OpenBehavior/ACRoBaT-center-out-task-platform/build-files/stl-autocad-files/Target - Left Slot.stl

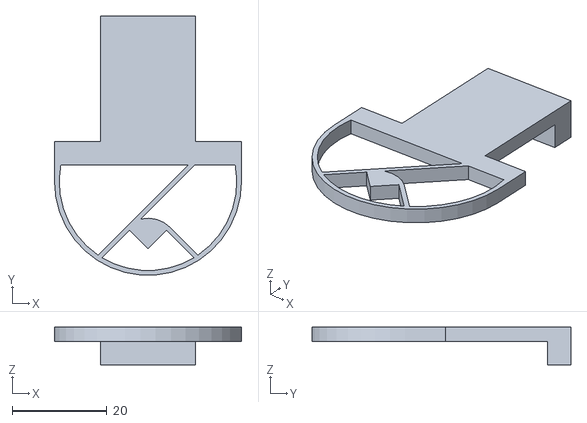
[picture p3: CAD file, 2017-10-06]
build-files/stl-autocad-files/Target - Left Slot.stl
39.5 x 54.7 x 8.00
