OpenBehavior/ACRoBaT-center-out-task-platform/build-files/stl-autocad-files/Joystick - Shaft.stl

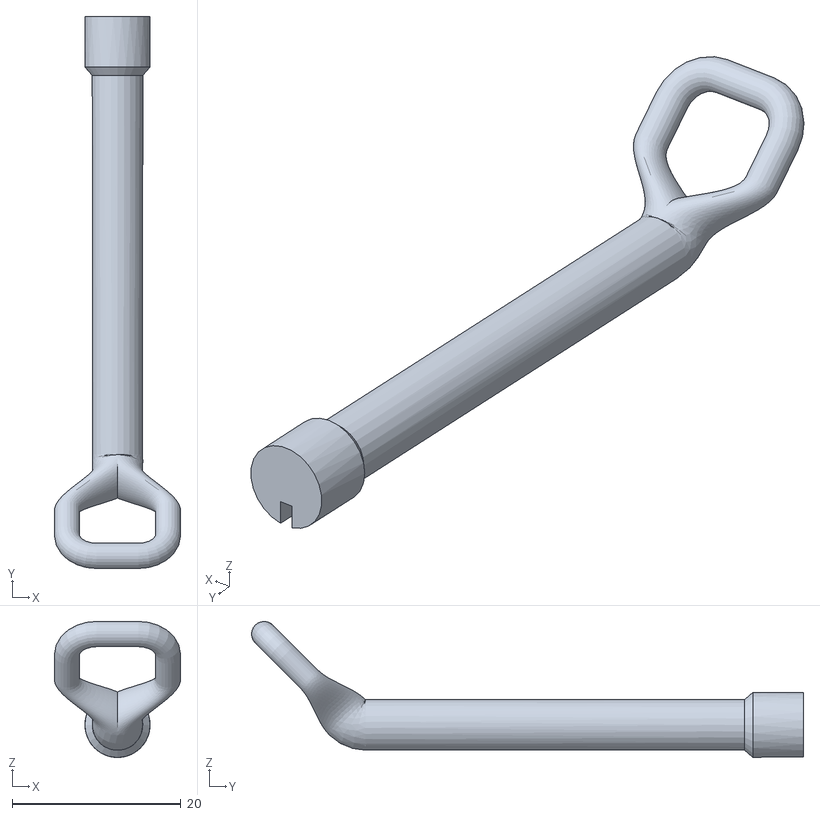
[picture p4: CAD file, 2017-10-06]
build-files/stl-autocad-files/Joystick - Shaft.stl
15.0 x 65.5 x 16.2
