OpenBehavior/ACRoBaT-center-out-task-platform/build-files/stl-autocad-files/Joystick - Female Socket.stl

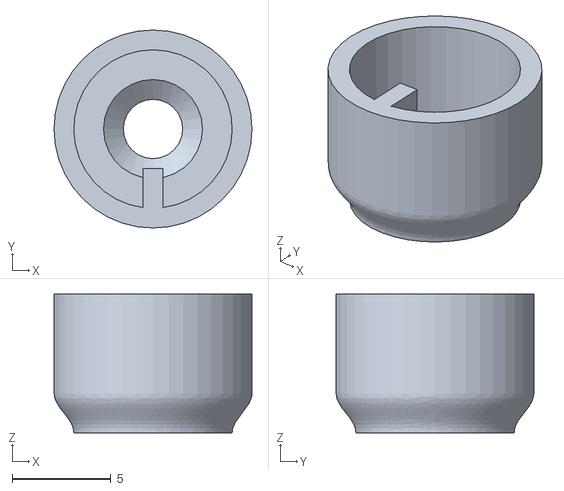
[picture p5: CAD file, 2017-10-06]
build-files/stl-autocad-files/Joystick - Female Socket.stl
10.0 x 10.0 x 7.00
