OpenBehavior/ACRoBaT-center-out-task-platform/build-files/stl-autocad-files/Targets - 3 Slots.stl

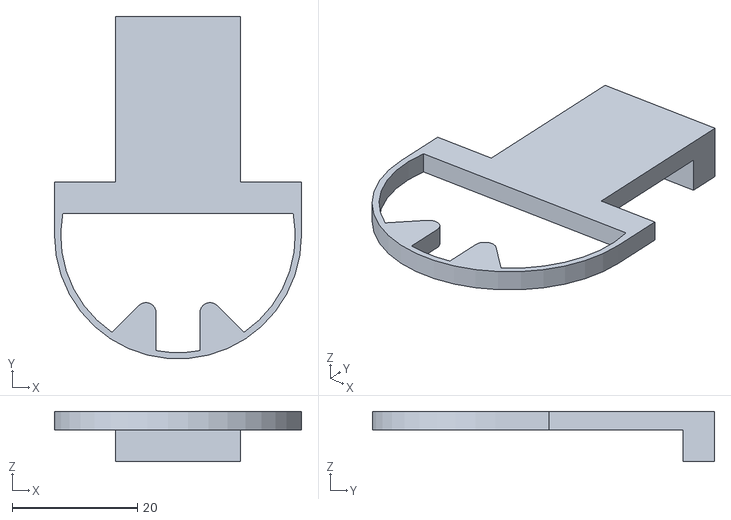
[picture p6: CAD file, 2017-10-06]
build-files/stl-autocad-files/Targets - 3 Slots.stl
39.5 x 54.7 x 8.00
