OpenBehavior/ACRoBaT-center-out-task-platform/build-files/stl-autocad-files/Arena Mounting Plate - Right.stl

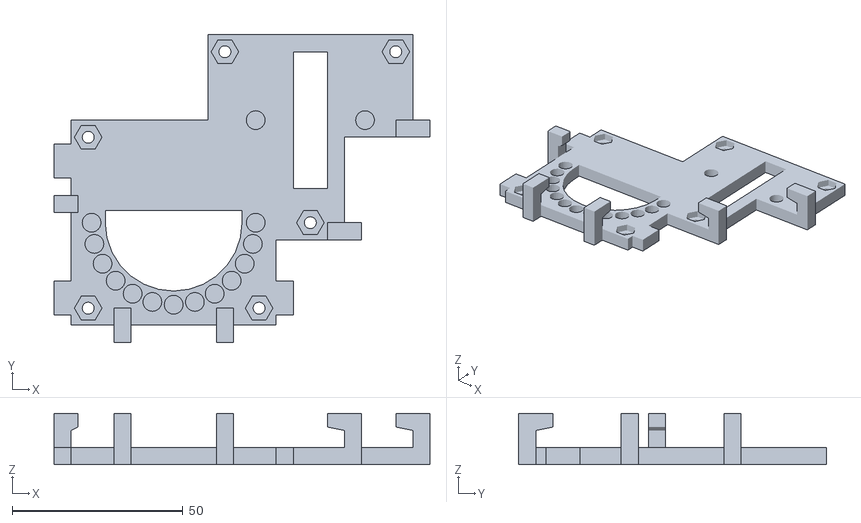
[picture p7: CAD file, 2017-10-06]
build-files/stl-autocad-files/Arena Mounting Plate - Right.stl
110.0 x 90.0 x 15.0
