OpenBehavior/ACRoBaT-center-out-task-platform/build-files/stl-autocad-files/Mounting Bracket - Sipper Tube.stl

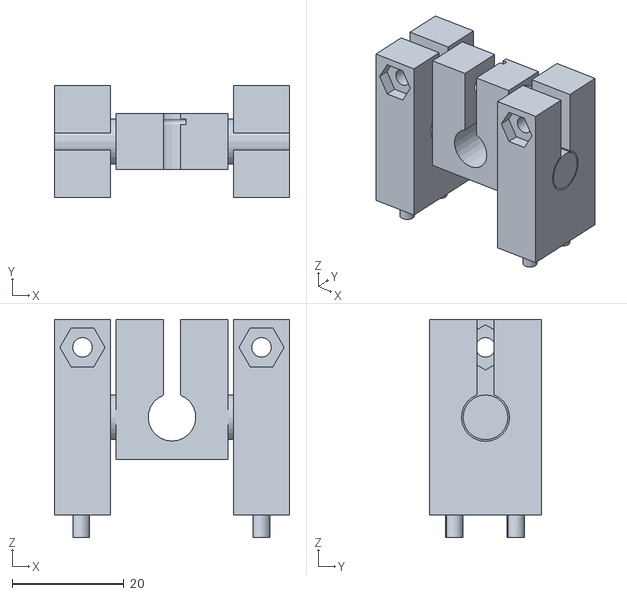
[picture p8: CAD file, 2017-10-06]
build-files/stl-autocad-files/Mounting Bracket - Sipper Tube.stl
42.0 x 20.0 x 39.0
