OpenBehavior/ACRoBaT-center-out-task-platform/build-files/stl-autocad-files/Mounting Bracket - Peristaltic Pump and Juice.stl

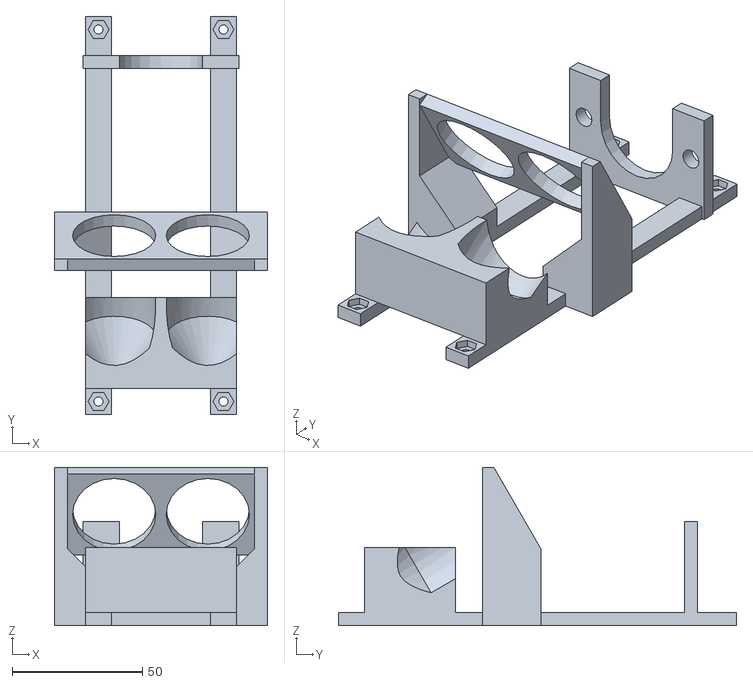
[picture p9: CAD file, 2017-10-06]
build-files/stl-autocad-files/Mounting Bracket - Peristaltic Pump and Juice.stl
82.0 x 153.0 x 60.7
