OpenBehavior/ACRoBaT-center-out-task-platform/build-files/stl-autocad-files/ACRoBaT Base Place - Left.stl

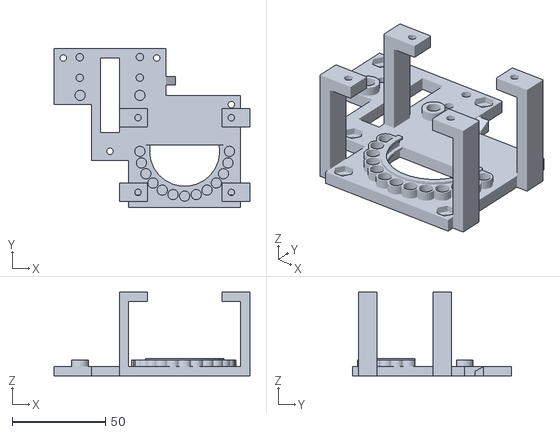
[picture p10: CAD file, 2017-10-06]
build-files/stl-autocad-files/ACRoBaT Base Place - Left.stl
105.0 x 85.0 x 45.0
