OpenBehavior/ACRoBaT-center-out-task-platform/build-files/stl-autocad-files/Mounting Bracket - Hall Effect Joystick.stl

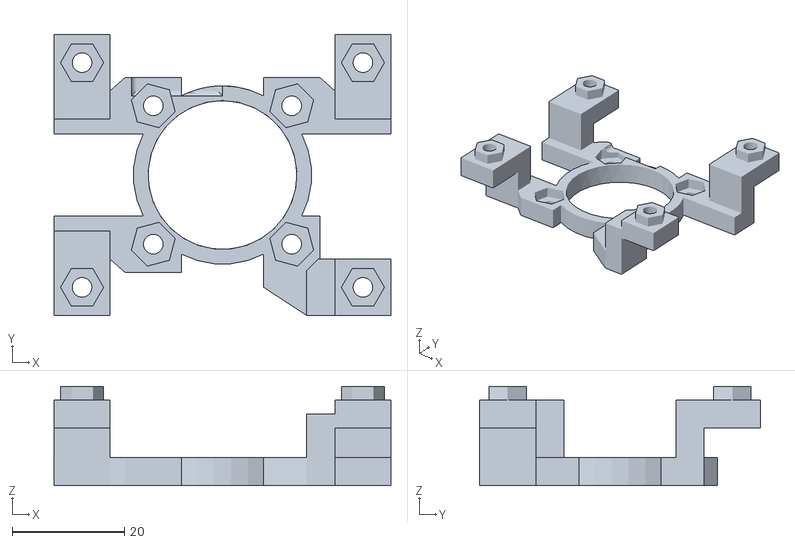
[picture p11: CAD file, 2017-10-06]
build-files/stl-autocad-files/Mounting Bracket - Hall Effect Joystick.stl
60.0 x 50.0 x 17.7
