OpenBehavior/ACRoBaT-center-out-task-platform/build-files/stl-autocad-files/Targets - 2 Slots.stl

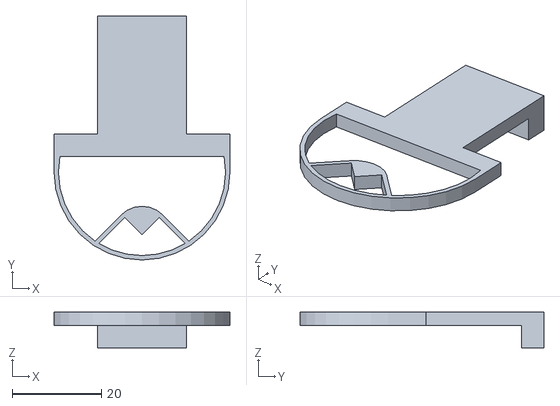
[picture p12: CAD file, 2017-10-06]
build-files/stl-autocad-files/Targets - 2 Slots.stl
39.5 x 54.8 x 8.00
