OpenBehavior/ACRoBaT-center-out-task-platform/(list of files, cad)

Other CAD files:
build-files/stl-autocad-files/Targets - Right Slot.stl
build-files/stl-autocad-files/Arena Mounting Plate - Left.stl
build-files/stl-autocad-files/ACRoBaT Base Plate - Right.stl
