OpenBehavior/ACRoBaT-center-out-task-platform/build-files/pcb-brd-files/ACRoBaT - main board.brd

## EAGLE design build-files/pcb-brd-files/ACRoBaT - main board.brd (2017-10-06)

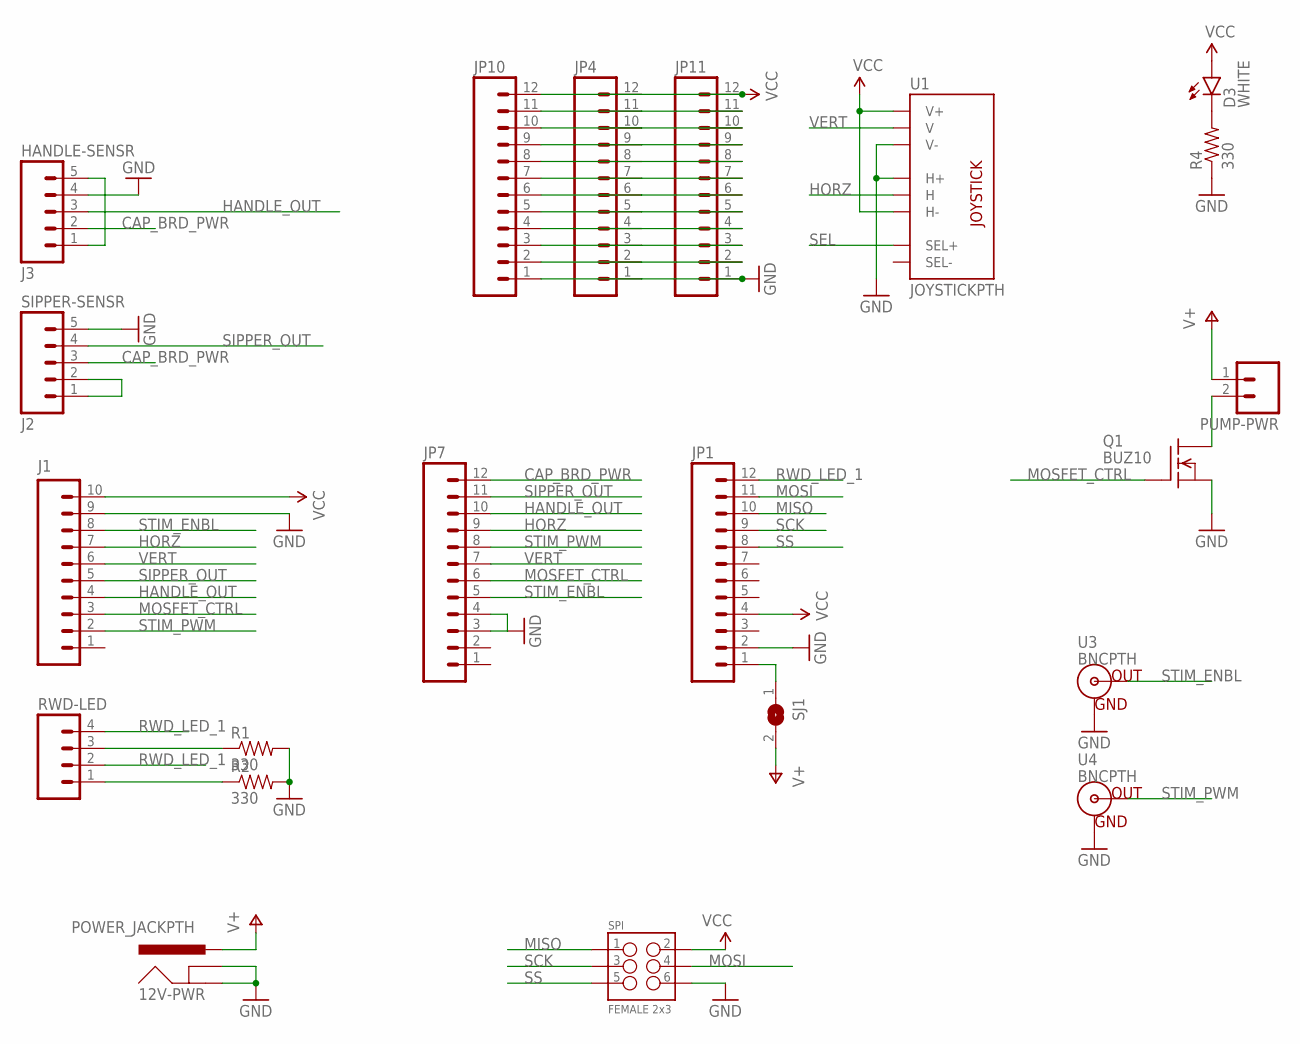
[picture p13: schematic ACRoBaT - main board.sch]

Parts:
12V-PWR: POWER_JACKPTH; POWER_JACK_PTH
D3: WHITE; LED-1206
HANDLE-SENSR: J3; 1X05
J1: M10SILK_FEMALE_PTH; 1X10
JP1, JP4, JP7, JP10, JP11: M12PTH; 1X12
PUMP-PWR: M02PTH; 1X02
Q1: BUZ10; TO220
R1, R2, R4: 330; AXIAL-0.3
RWD-LED: M04PTH; 1X04
SIPPER-SENSR: J2; 1X05
SJ1: SJ
SPI: FEMALE 2x3; 2X3
U1: JOYSTICKPTH; JOYSTICK
U3, U4: BNCPTH; BNC

Connections:
CAP_BRD_PWR: HANDLE-SENSR.2, JP7.12, SIPPER-SENSR.3
GND: 12V-PWR.GND, 12V-PWR.GNDBREAK, HANDLE-SENSR.4, J1.9, JP1.2, JP4.1, JP7.3, JP7.4, JP10.1, JP11.1, Q1.3 (S), R1.P$2 (2), R2.P$2 (2), R4.P$1 (1), SIPPER-SENSR.5, SPI.6, U1.H1 (H+), U1.V3 (V-), U3.GND, U4.GND
HANDLE_OUT: HANDLE-SENSR.3, J1.4, JP7.10
HORZ: J1.7, JP7.9, U1.H2 (H)
MISO: JP1.10, SPI.1
MOSFET_CTRL: J1.3, JP7.6, Q1.1 (G)
MOSI: JP1.11, SPI.4
unnamed: HANDLE-SENSR.1, HANDLE-SENSR.5
unnamed: SIPPER-SENSR.1, SIPPER-SENSR.2
unnamed: D3.C, R4.P$2 (2)
unnamed: JP4.11, JP10.11, JP11.11
unnamed: R1.P$1 (1), RWD-LED.3
unnamed: R2.P$1 (1), RWD-LED.1
unnamed: JP4.10, JP10.10, JP11.10
unnamed: JP4.9, JP10.9, JP11.9
unnamed: JP4.8, JP10.8, JP11.8
unnamed: JP4.7, JP10.7, JP11.7
unnamed: JP4.6, JP10.6, JP11.6
unnamed: JP4.5, JP10.5, JP11.5
unnamed: JP4.4, JP10.4, JP11.4
unnamed: JP4.3, JP10.3, JP11.3
unnamed: JP4.2, JP10.2, JP11.2
unnamed: PUMP-PWR.2, Q1.2 (D)
unnamed: JP1.1, SJ1.1
RWD_LED_1: JP1.12, RWD-LED.2, RWD-LED.4
SCK: JP1.9, SPI.3
SEL: U1.B1A (SEL+)
SIPPER_OUT: J1.5, JP7.11, SIPPER-SENSR.4
SS: JP1.8, SPI.5
STIM_ENBL: J1.8, JP7.5, U3.S (OUT)
STIM_PWM: J1.2, JP7.8, U4.S (OUT)
V+: 12V-PWR.PWR, PUMP-PWR.1, SJ1.2
VCC: D3.A, J1.10, JP1.4, JP4.12, JP10.12, JP11.12, SPI.2, U1.H3 (H-), U1.V1 (V+)
VERT: J1.6, JP7.7, U1.V2 (V)

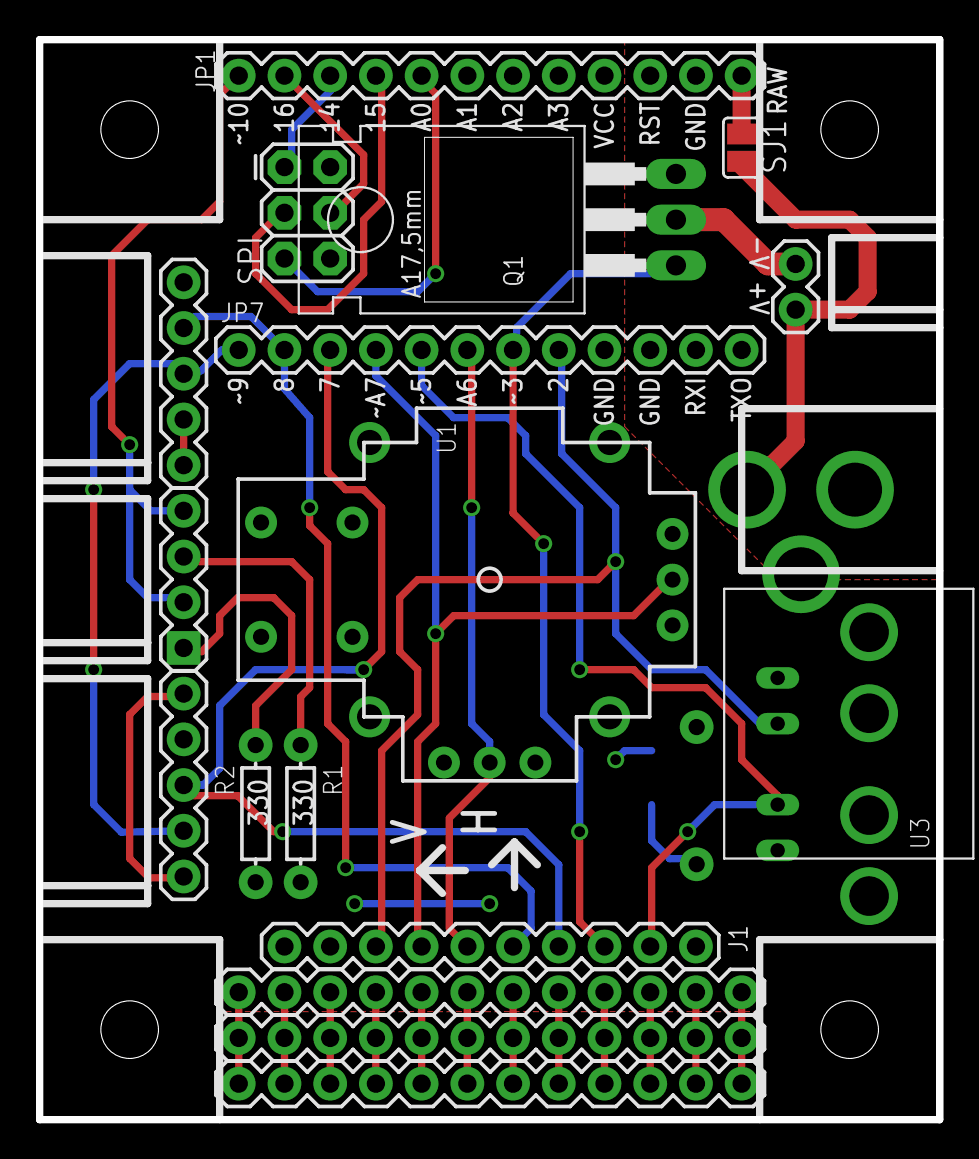
[picture p14: board ACRoBaT - main board.brd from above]

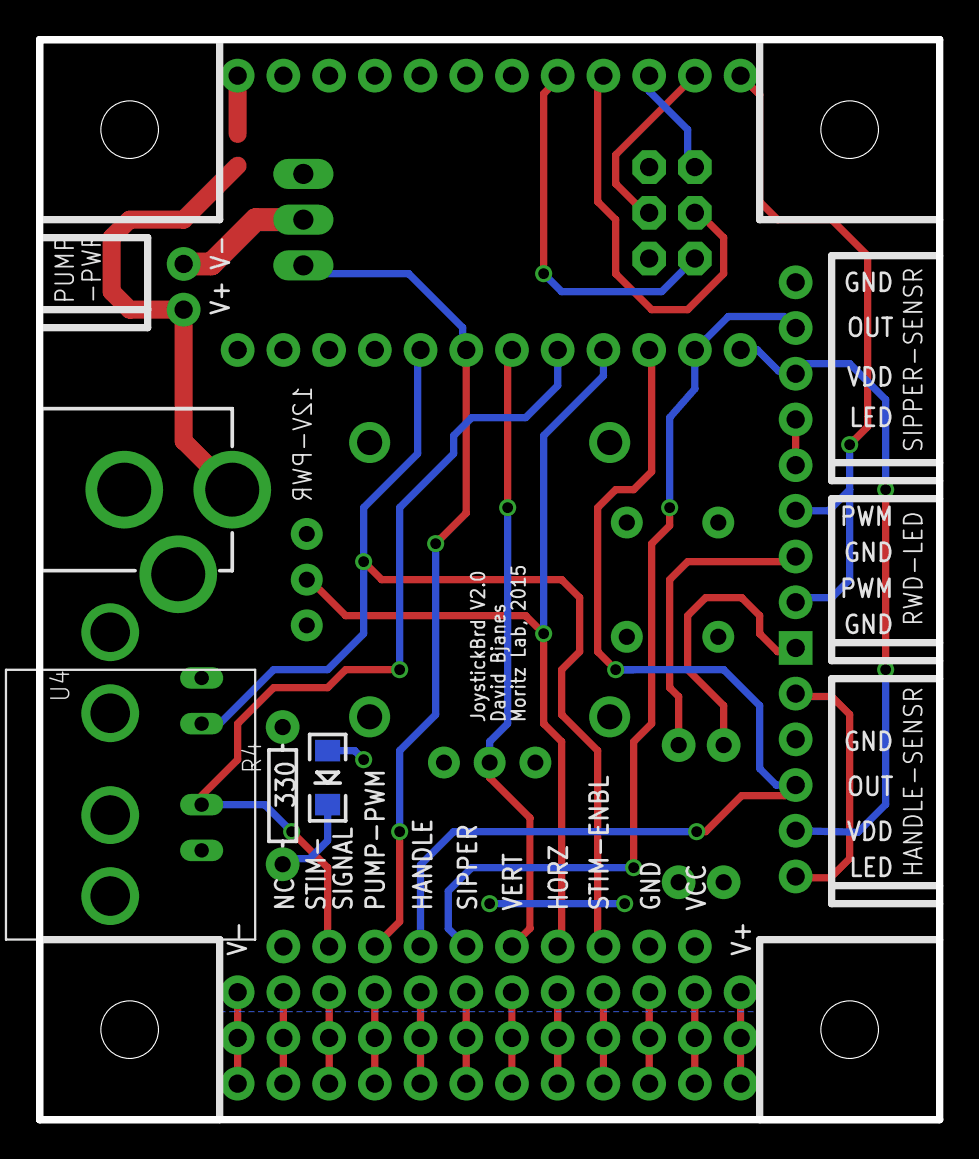
[picture p15: board ACRoBaT - main board.brd from below]

Board: 2 copper layers, 50.0 x 60.0 mm, 21 parts (4 on the bottom side), 33 nets.
