OpenBehavior/ACRoBaT-center-out-task-platform/build-files/pcb-brd-files/ACRoBaT - led board.brd

## EAGLE design build-files/pcb-brd-files/ACRoBaT - led board.brd (2017-10-06)

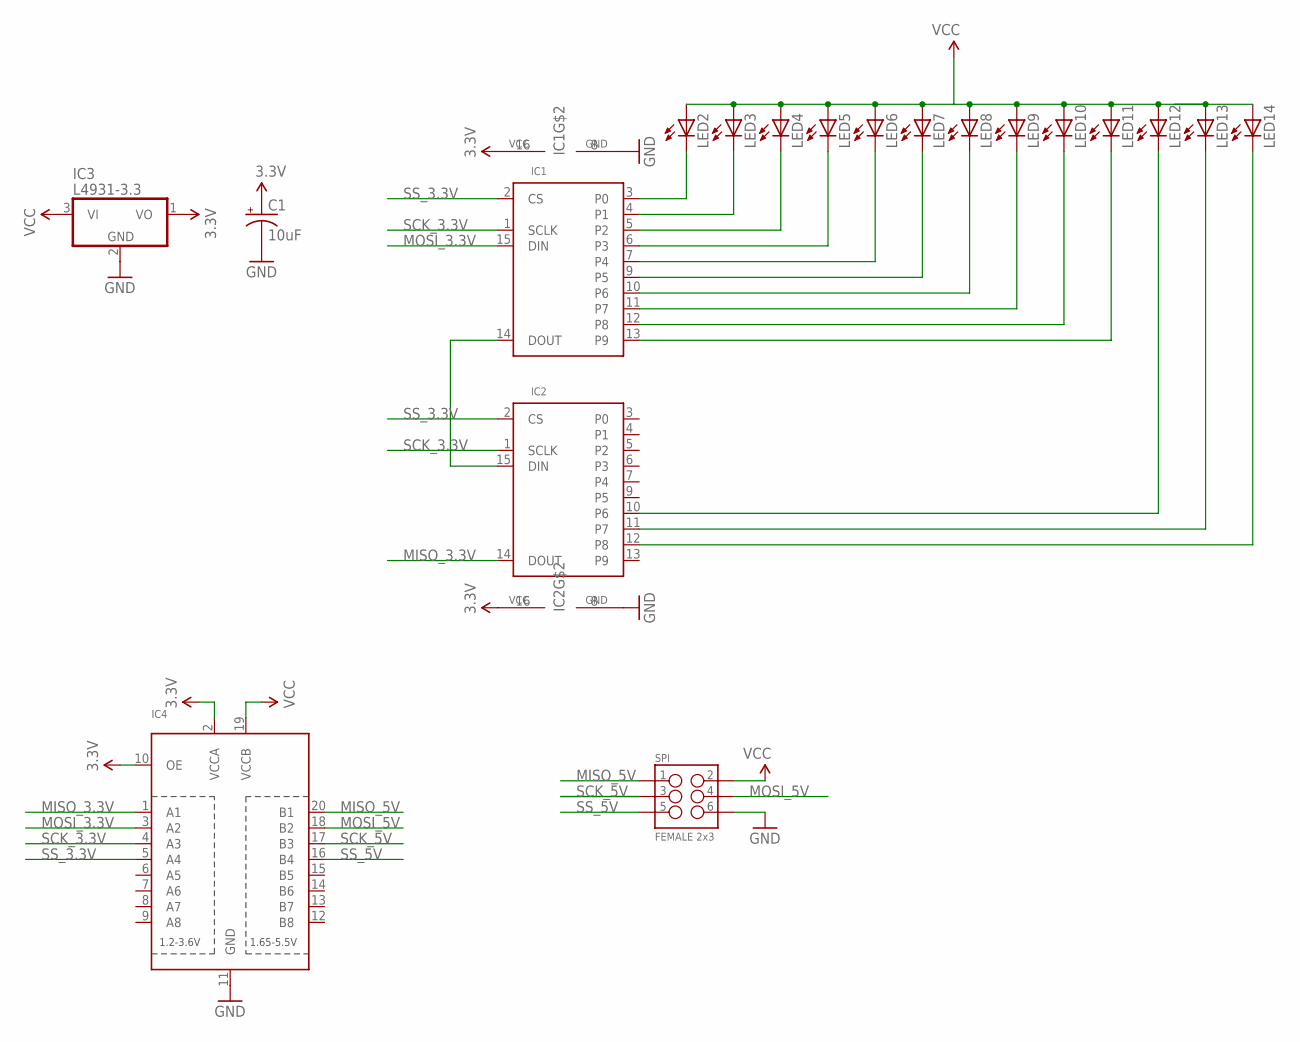
[picture p16: schematic ACRoBaT - led board.sch]

Parts:
C1: 10uF; CPOL-RADIAL-10UF-25V
IC1, IC2: MAX6966AEE; QSOP16
IC3: L4931-3.3; TO92
IC4: TXB0108PWR; TSSOP20
LED2, LED3, LED4, LED5, LED6, LED7, LED8, LED9, LED10, LED11, LED12, LED13, LED14: LED5MM
SPI: FEMALE 2x3; 2X3

Connections:
3.3V: C1.1 (+), IC1.16 (VCC), IC2.16 (VCC), IC3.1 (VO), IC4.2 (VCCA), IC4.10 (OE)
DOUT_3.3V: IC1.14 (DOUT), IC2.15 (DIN)
GND: C1.2 (-), IC1.8 (GND), IC2.8 (GND), IC3.2 (GND), IC4.11 (GND), SPI.6
MISO_3.3V: IC2.14 (DOUT), IC4.1 (A1)
MISO_5V: IC4.20 (B1), SPI.1
MOSI_3.3V: IC1.15 (DIN), IC4.3 (A2)
MOSI_5V: IC4.18 (B2), SPI.4
unnamed: IC1.3 (P0), LED2.K (C)
unnamed: IC1.4 (P1), LED3.K (C)
unnamed: IC1.5 (P2), LED4.K (C)
unnamed: IC1.6 (P3), LED5.K (C)
unnamed: IC1.7 (P4), LED6.K (C)
unnamed: IC1.9 (P5), LED7.K (C)
unnamed: IC1.10 (P6), LED8.K (C)
unnamed: IC1.11 (P7), LED9.K (C)
unnamed: IC1.12 (P8), LED10.K (C)
unnamed: IC1.13 (P9), LED11.K (C)
unnamed: IC2.10 (P6), LED12.K (C)
unnamed: IC2.11 (P7), LED13.K (C)
unnamed: IC2.12 (P8), LED14.K (C)
SCK_3.3V: IC1.1 (SCLK), IC2.1 (SCLK), IC4.4 (A3)
SCK_5V: IC4.17 (B3), SPI.3
SS_3.3V: IC1.2 (CS), IC2.2 (CS), IC4.5 (A4)
SS_5V: IC4.16 (B4), SPI.5
VCC: IC3.3 (VI), IC4.19 (VCCB), LED2.A, LED3.A, LED4.A, LED5.A, LED6.A, LED7.A, LED8.A, LED9.A, LED10.A, LED11.A, LED12.A, LED13.A, LED14.A, SPI.2

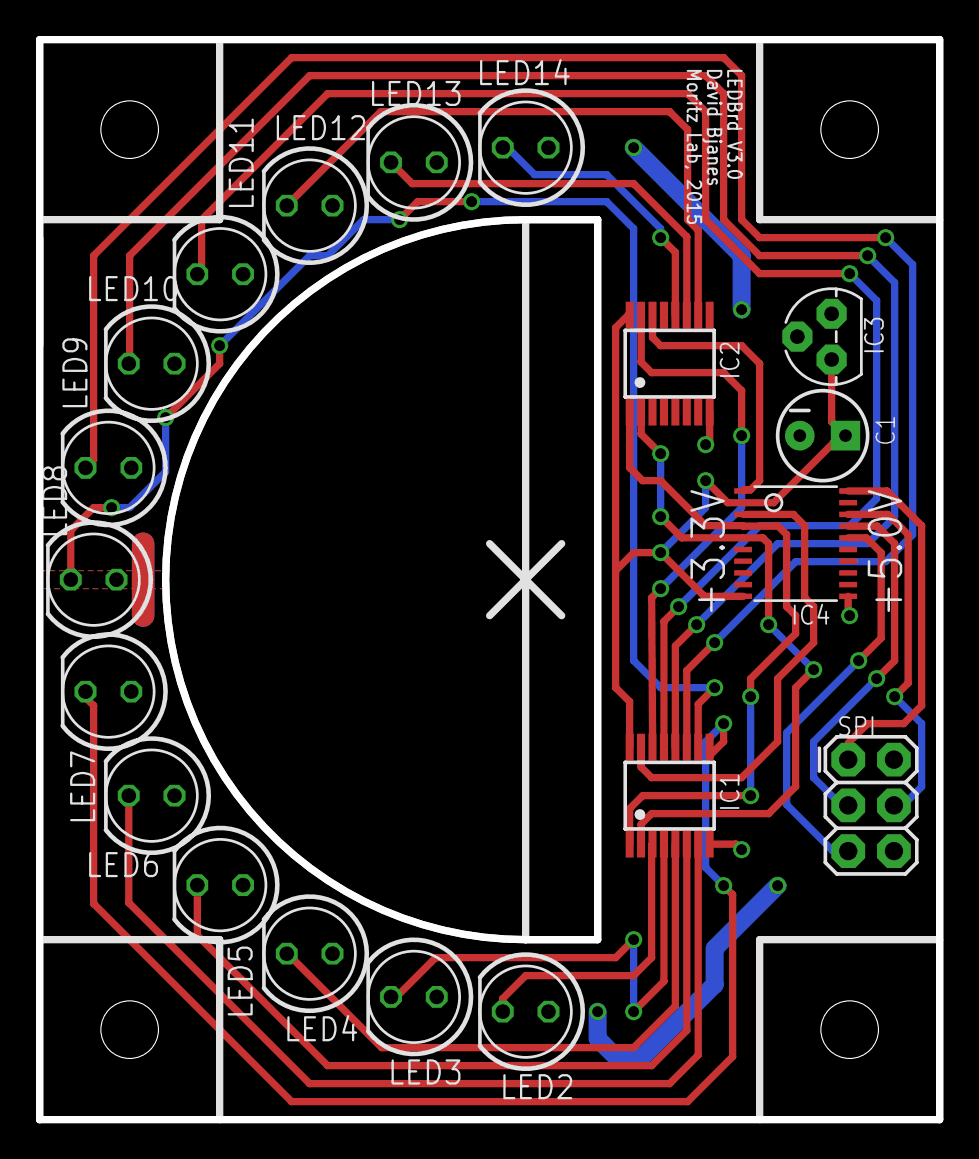
[picture p17: board ACRoBaT - led board.brd from above]

Board: 2 copper layers, 50.0 x 60.0 mm, 19 parts (0 on the bottom side), 25 nets.
